LZ1DPN/Minima-2016/other-docs/Arduino-ProMini-pinout.png

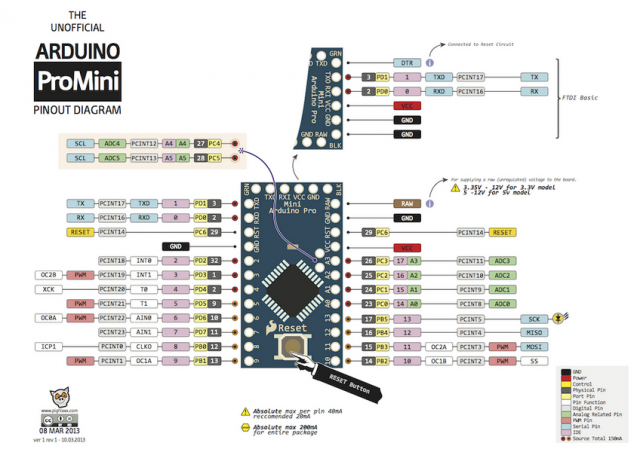
other-docs/Arduino-ProMini-pinout.png
