LZ1DPN/Minima-2016/other-docs/Version3_Schematic.jpg

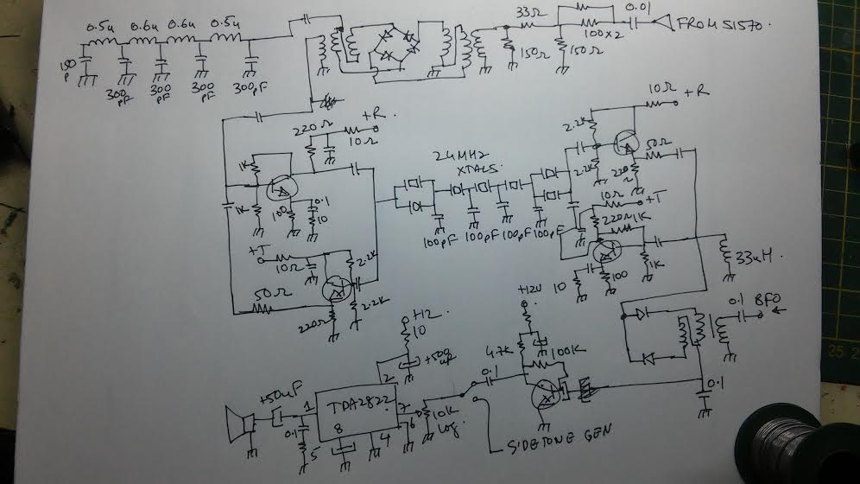
other-docs/Version3_Schematic.jpg
