LZ1DPN/Minima-2016/radiono20mhz/README.md

radiono
=======

Minima's Arduino software. Useful for controlling a homebrew Si570 based superhet transceiver/receiver.
It is primarily meant to be used with the Minima transceiver described on http://phonestack.com/farhan/minima.html

Copyright (C)2014  Ashhar Farhan

    This program is free software: you can redistribute it and/or modify
    it under the terms of the GNU General Public License as published by
    the Free Software Foundation, either version 3 of the License, or
    (at your option) any later version.

    This program is distributed in the hope that it will be useful,
    but WITHOUT ANY WARRANTY; without even the implied warranty of
    MERCHANTABILITY or FITNESS FOR A PARTICULAR PURPOSE.  See the
    GNU General Public License for more details.

    You should have received a copy of the GNU General Public License
    along with this program.  If not, see <http://www.gnu.org/licenses/>.
