LZ1DPN/Minima-2016/minima-pcb-up.jpg

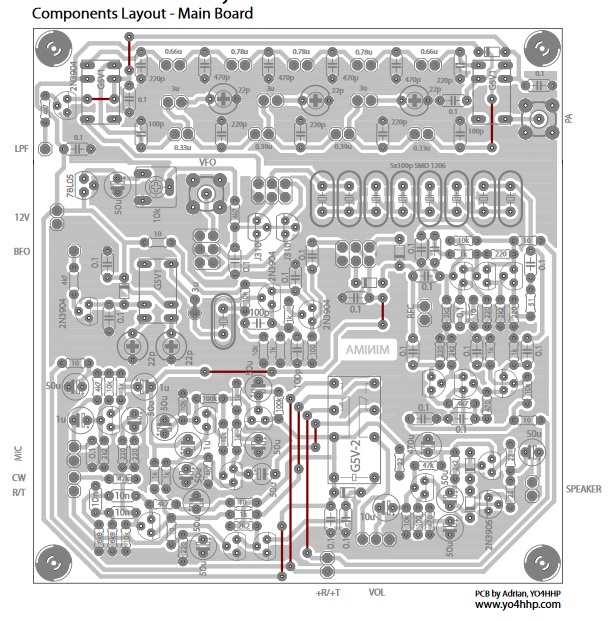
minima-pcb-up.jpg
