LZ1DPN/Minima-2016/other-docs/10W_40m_CW_Transmitter.gif

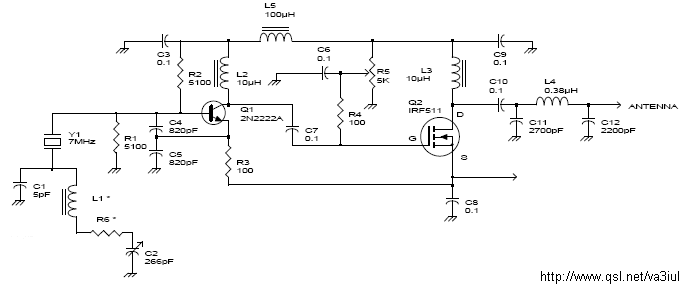
other-docs/10W_40m_CW_Transmitter.gif
