LZ1DPN/Minima-2016/other-docs/40m_12W_TX_NB6M.gif

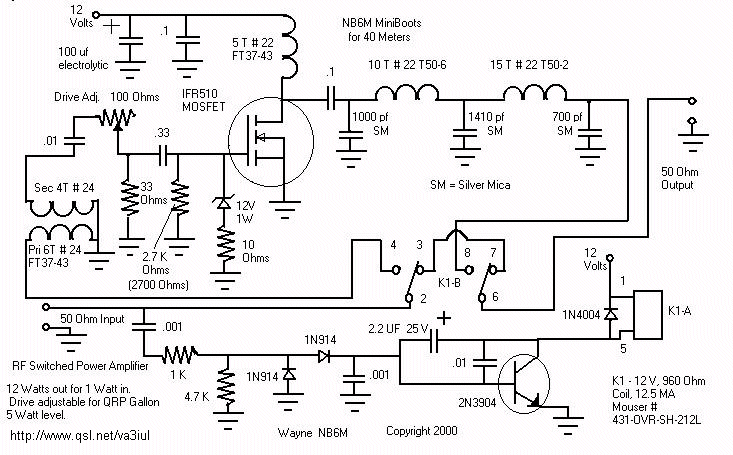
other-docs/40m_12W_TX_NB6M.gif
