LZ1DPN/Minima-2016/other-docs/1117.jpg

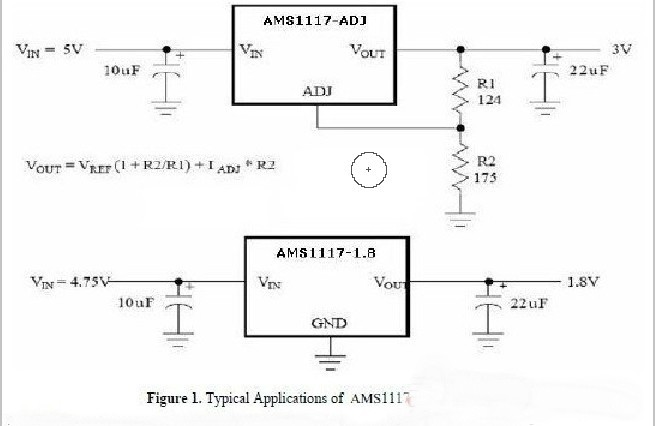
other-docs/1117.jpg
