LZ1DPN/Minima-2016/other-docs/20097132394231.gif.jpg

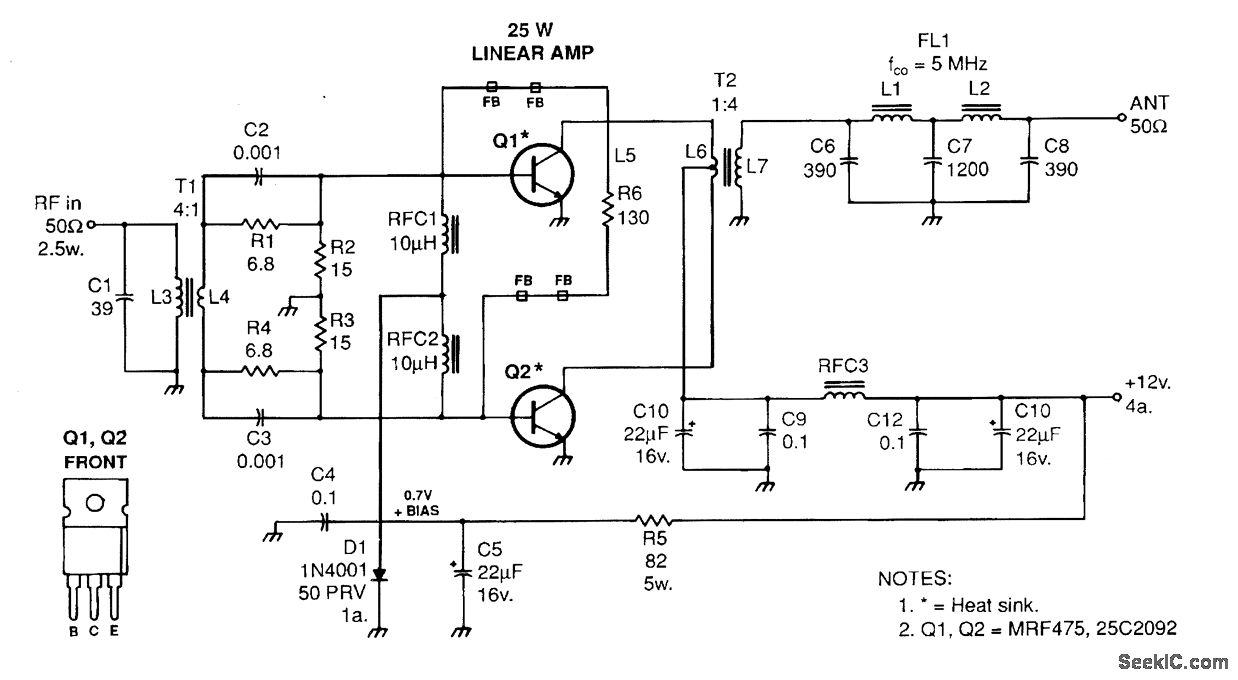
other-docs/20097132394231.gif.jpg
