LZ1DPN/Minima-2016/other-docs/arduino-pro-mini.jpg

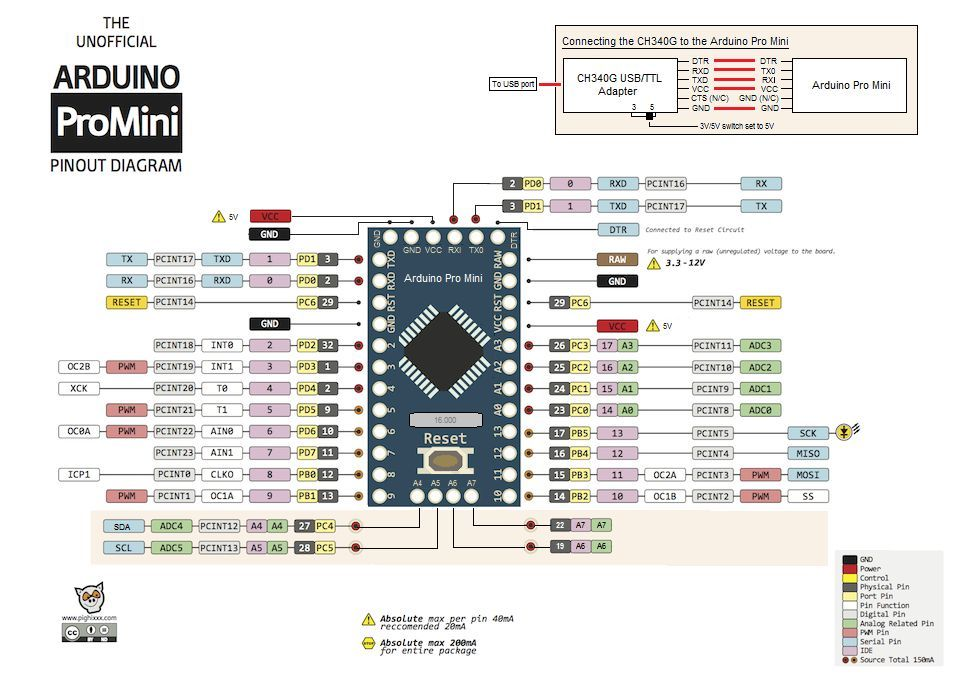
other-docs/arduino-pro-mini.jpg
