LZ1DPN/Minima-2016/other-docs/audio-af_mba810.jpg

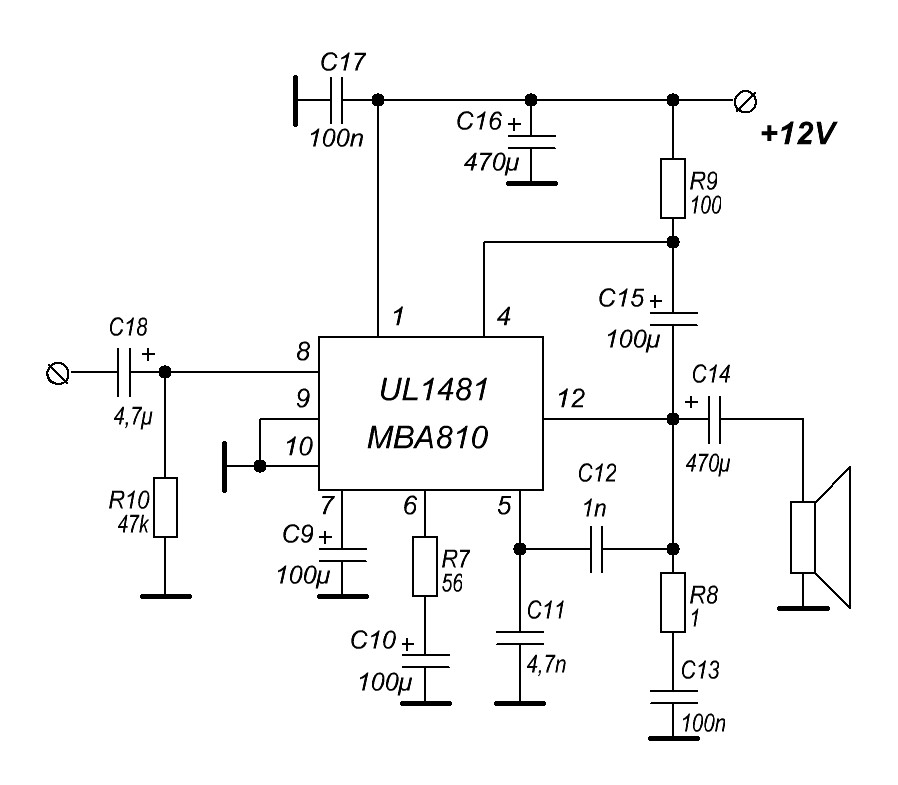
other-docs/audio-af_mba810.jpg
