LZ1DPN/Minima-2016/other-docs/audio-af_tda2003.jpg

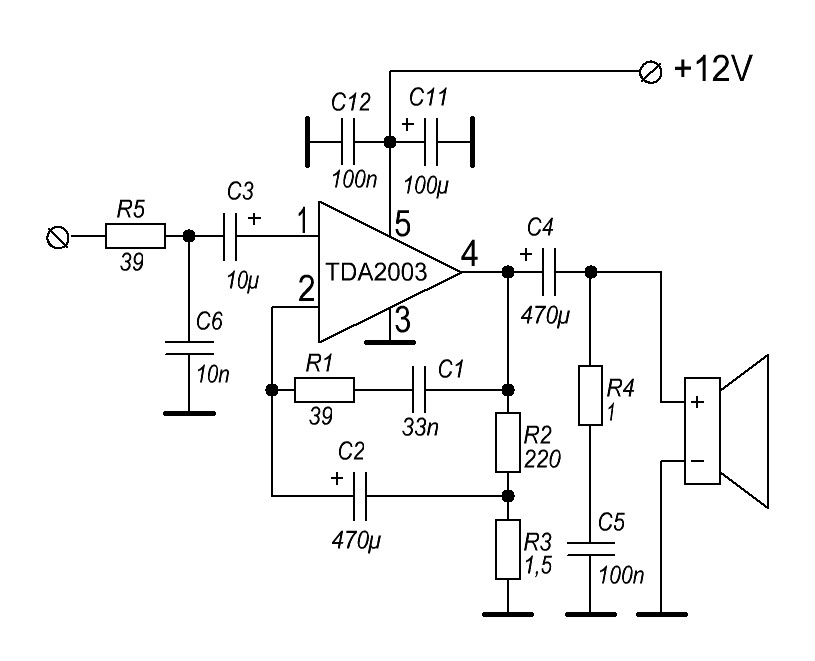
other-docs/audio-af_tda2003.jpg
