LZ1DPN/Minima-2016/other-docs/cw_gen.jpg

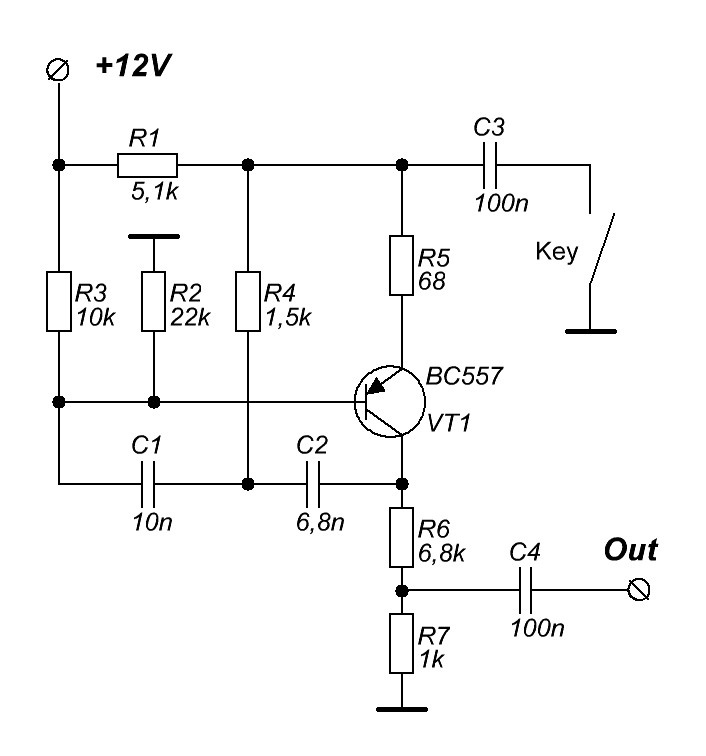
other-docs/cw_gen.jpg
