LZ1DPN/Minima-2016/other-docs/digi.jpg

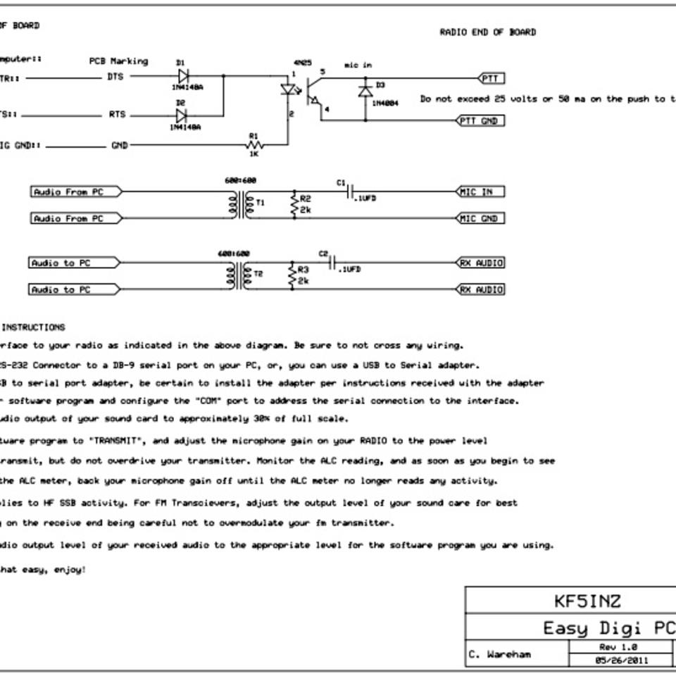
other-docs/digi.jpg
