LZ1DPN/Minima-2016/other-docs/linear_amplifier.gif

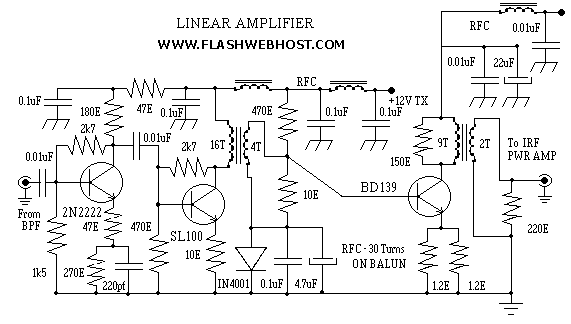
other-docs/linear_amplifier.gif
