LZ1DPN/Minima-2016/other-docs/lz1jn_swr.jpg

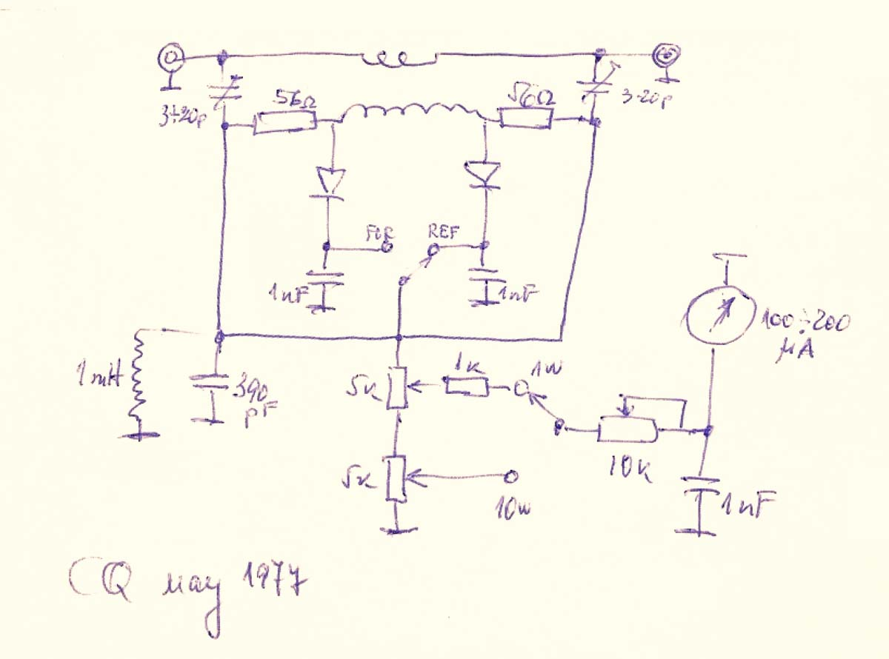
other-docs/lz1jn_swr.jpg
