LZ1DPN/Minima-2016/other-docs/Minima2.png

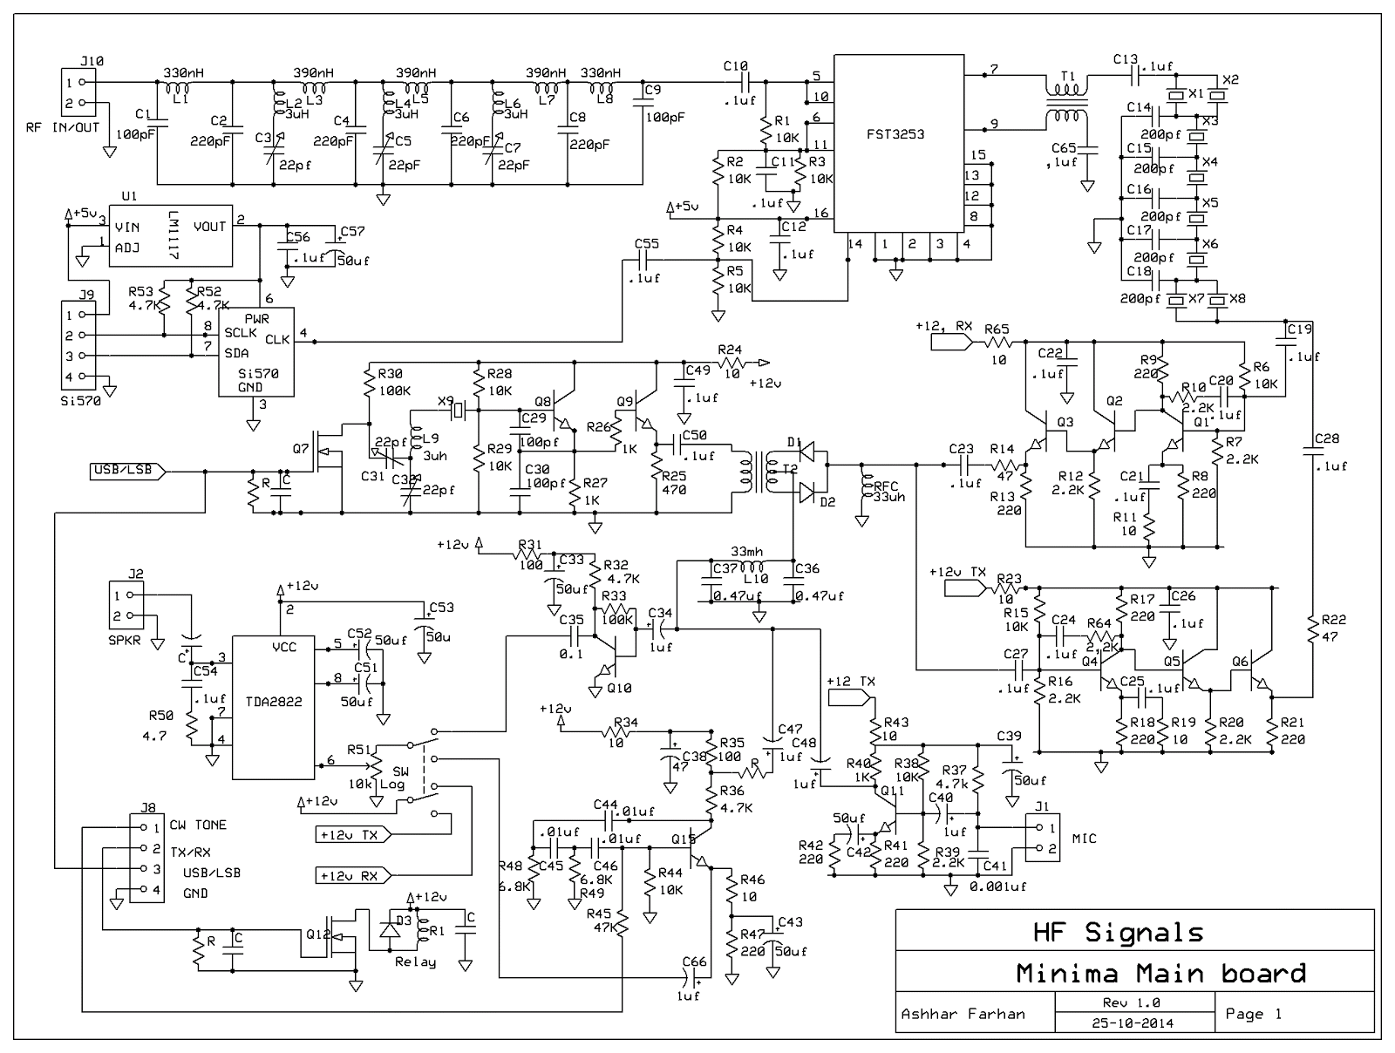
other-docs/Minima2.png
