LZ1DPN/Minima-2016/other-docs/minima-mb_layout.png

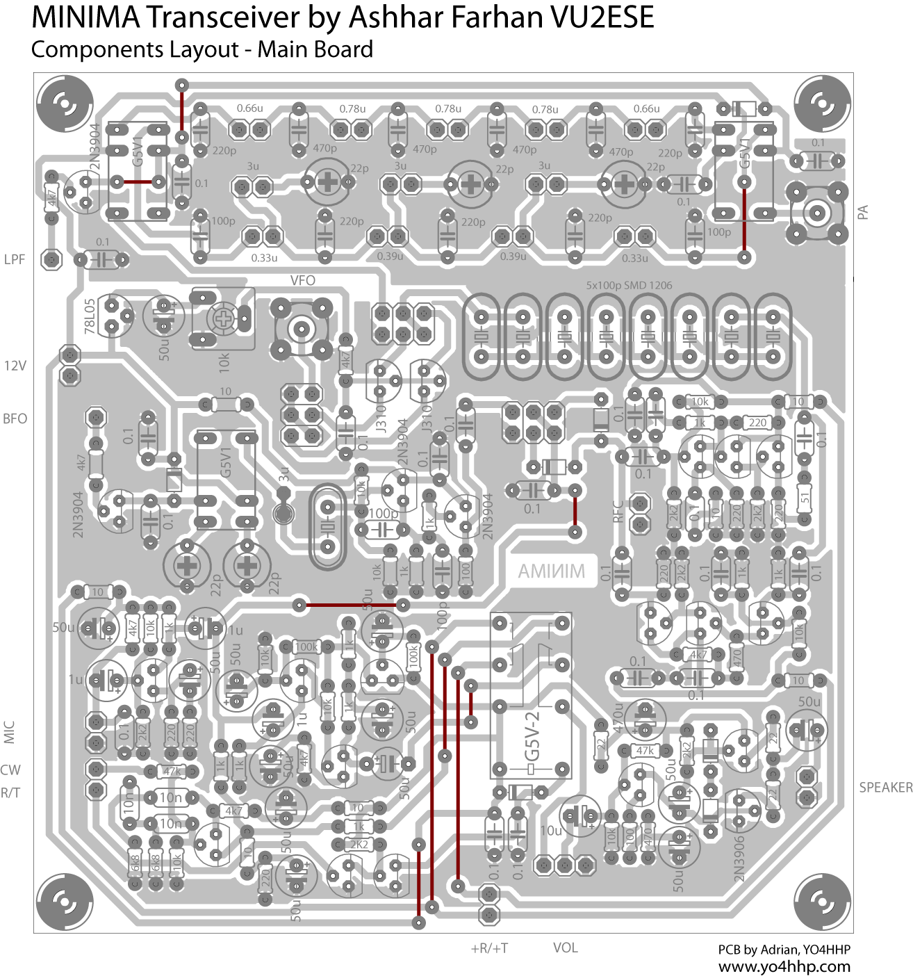
other-docs/minima-mb_layout.png
