LZ1DPN/Minima-2016/other-docs/minima-trx.jpg

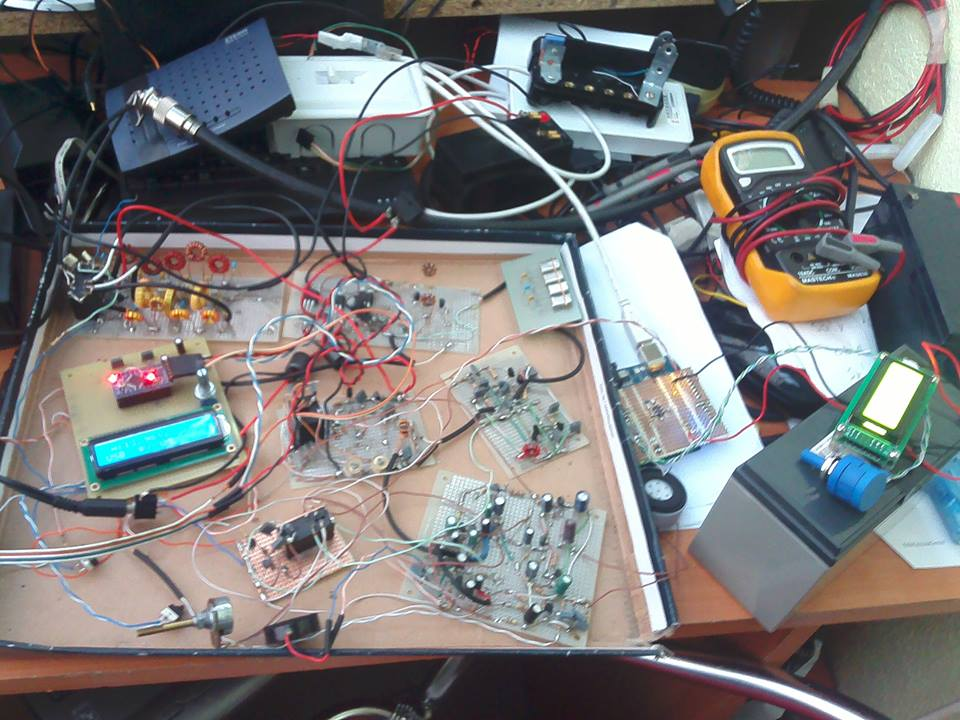
other-docs/minima-trx.jpg
