LZ1DPN/Minima-2016/other-docs/minimackt-rfamp.jpg

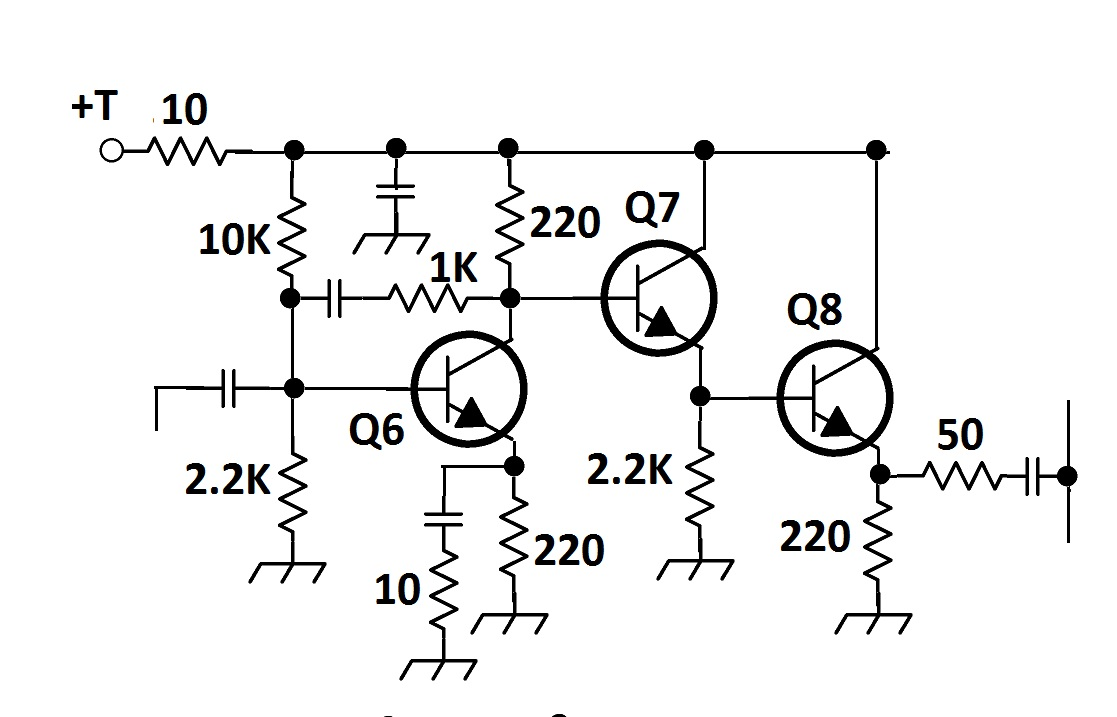
other-docs/minimackt-rfamp.jpg
