LZ1DPN/Minima-2016/other-docs/pa.jpg

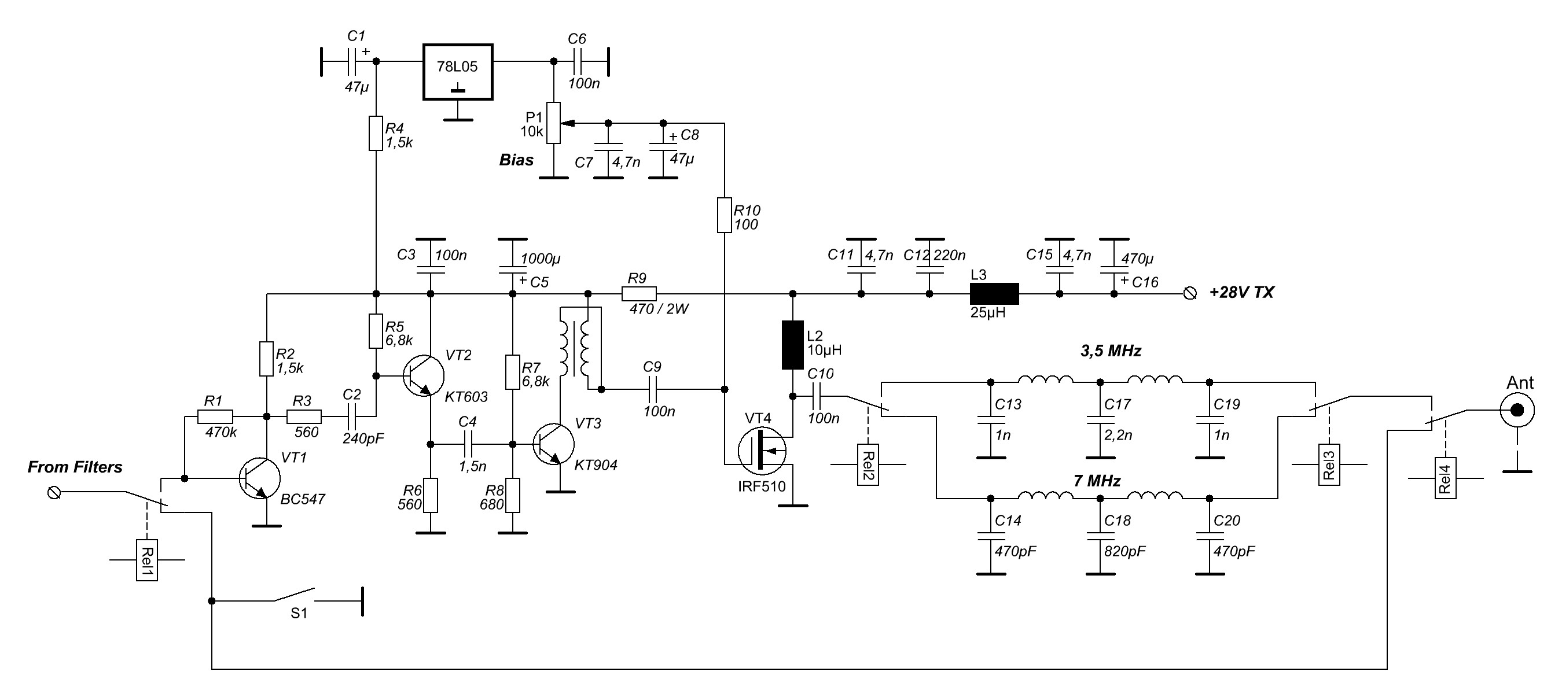
other-docs/pa.jpg
