LZ1DPN/Minima-2016/other-docs/rst_qrp_tx_boia_fria.gif

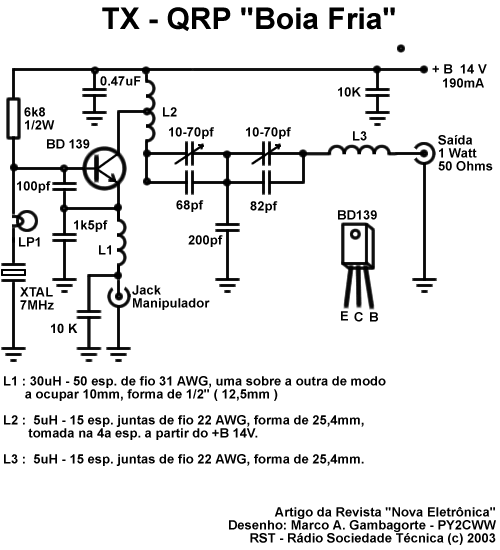
other-docs/rst_qrp_tx_boia_fria.gif
