LZ1DPN/Minima-2016/other-docs/Single-Transistor-Amplifier.gif

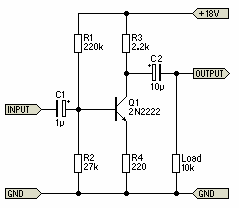
other-docs/Single-Transistor-Amplifier.gif
