LZ1DPN/Minima-2016/other-docs/sketch.jpg

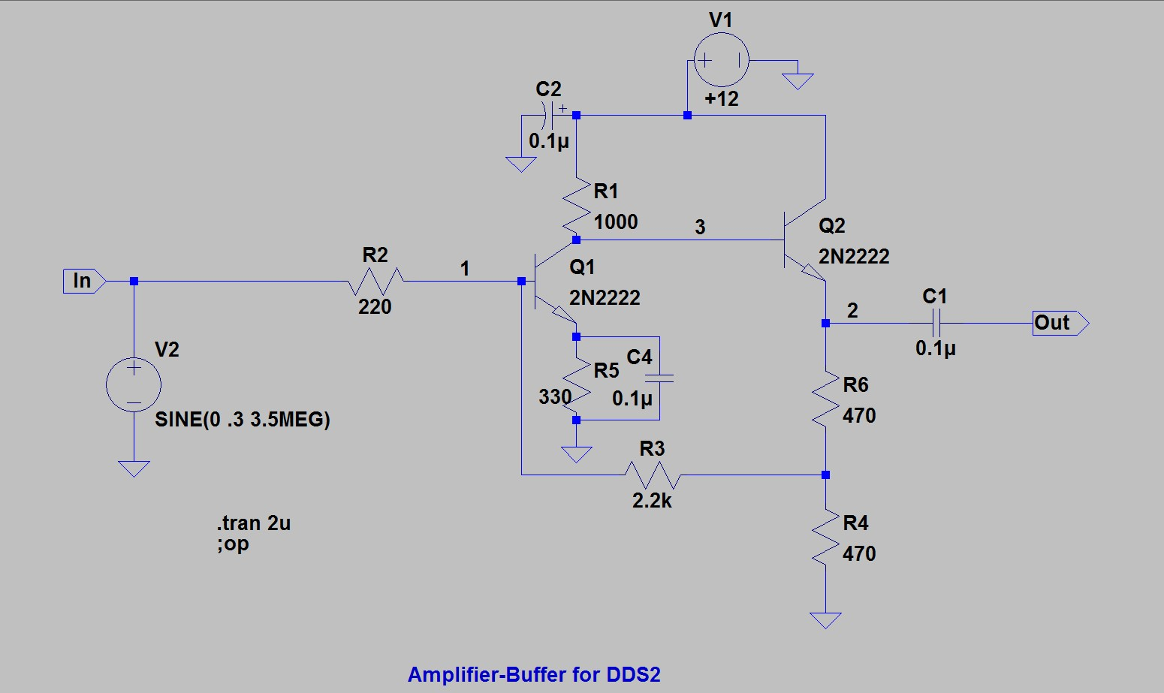
other-docs/sketch.jpg
