LZ1DPN/Minima-2016/other-docs/transistor-J310.jpg

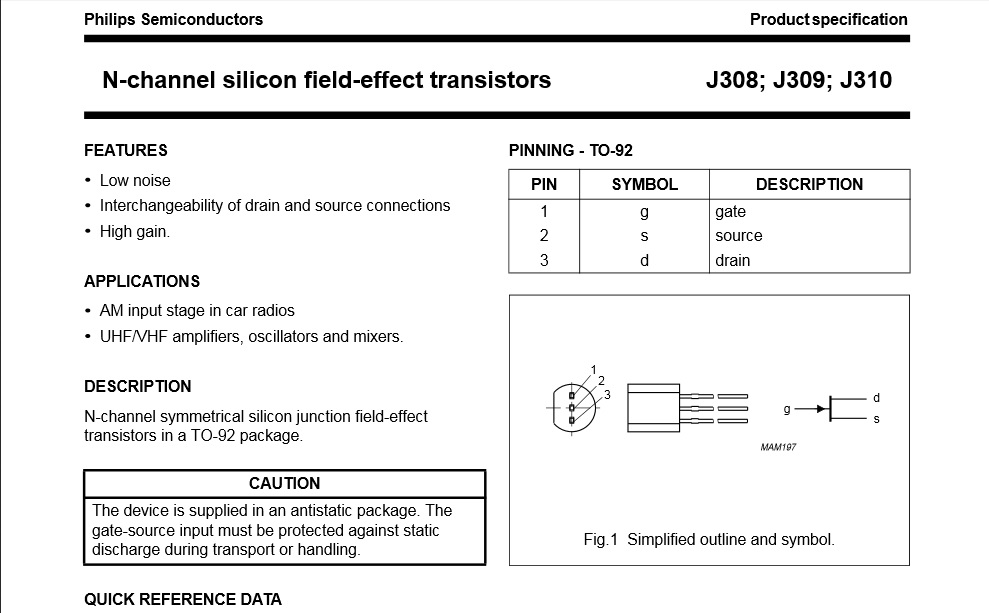
other-docs/transistor-J310.jpg
