LZ1DPN/Minima-2016/minima-mb_layout.pdf

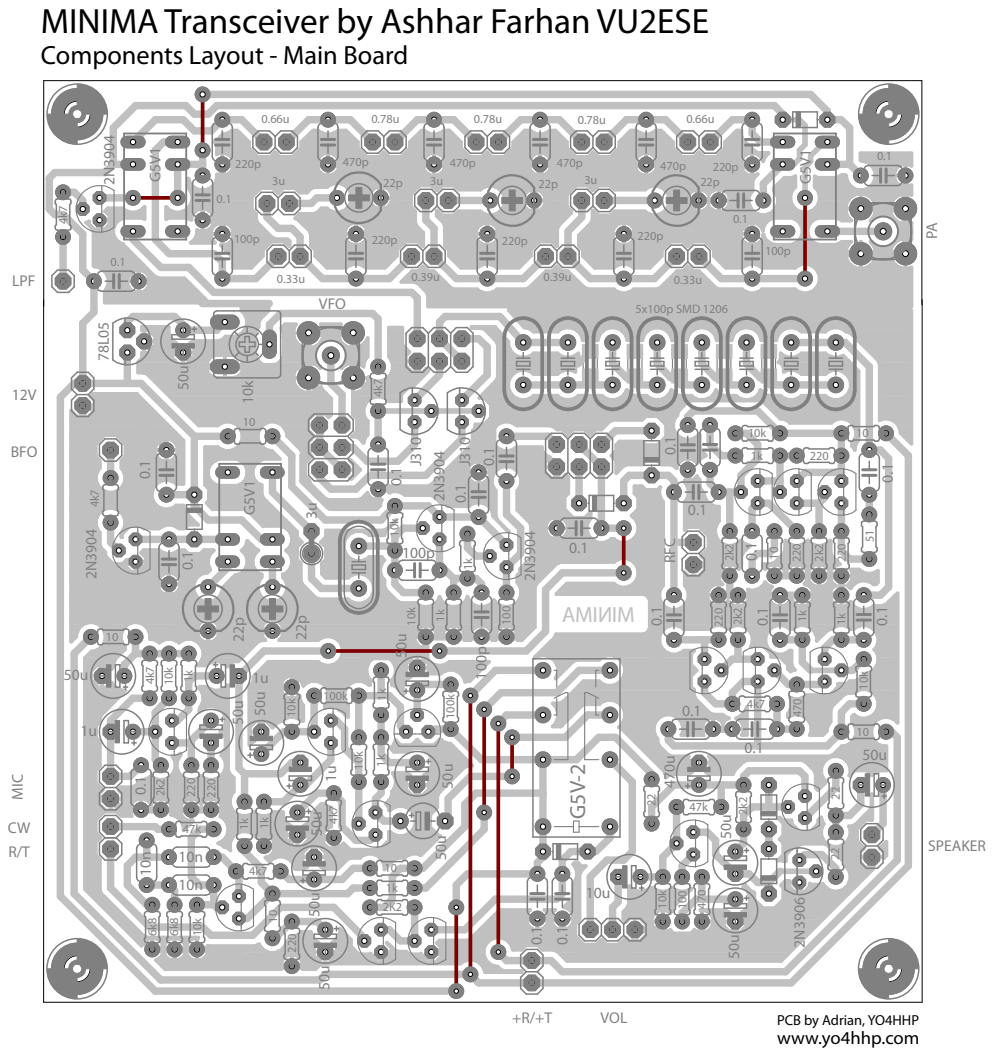
[picture p79: page 1]
RFC; MIC; 1u ²N³⁹⁰⁴; BFO; VFO; G5V-2 VOL; 10 ⁵⁰u; LPF; SPEAKER; 5x100p SMD 1206

MINIMA Transceiver by Ashhar Farhan VU2ESE
Components Layout - Main Board

PCB by Adrian, YO4HHP
www.yo4hhp.com
