LZ1DPN/Minima-2016/other-docs/HF1-1.pdf

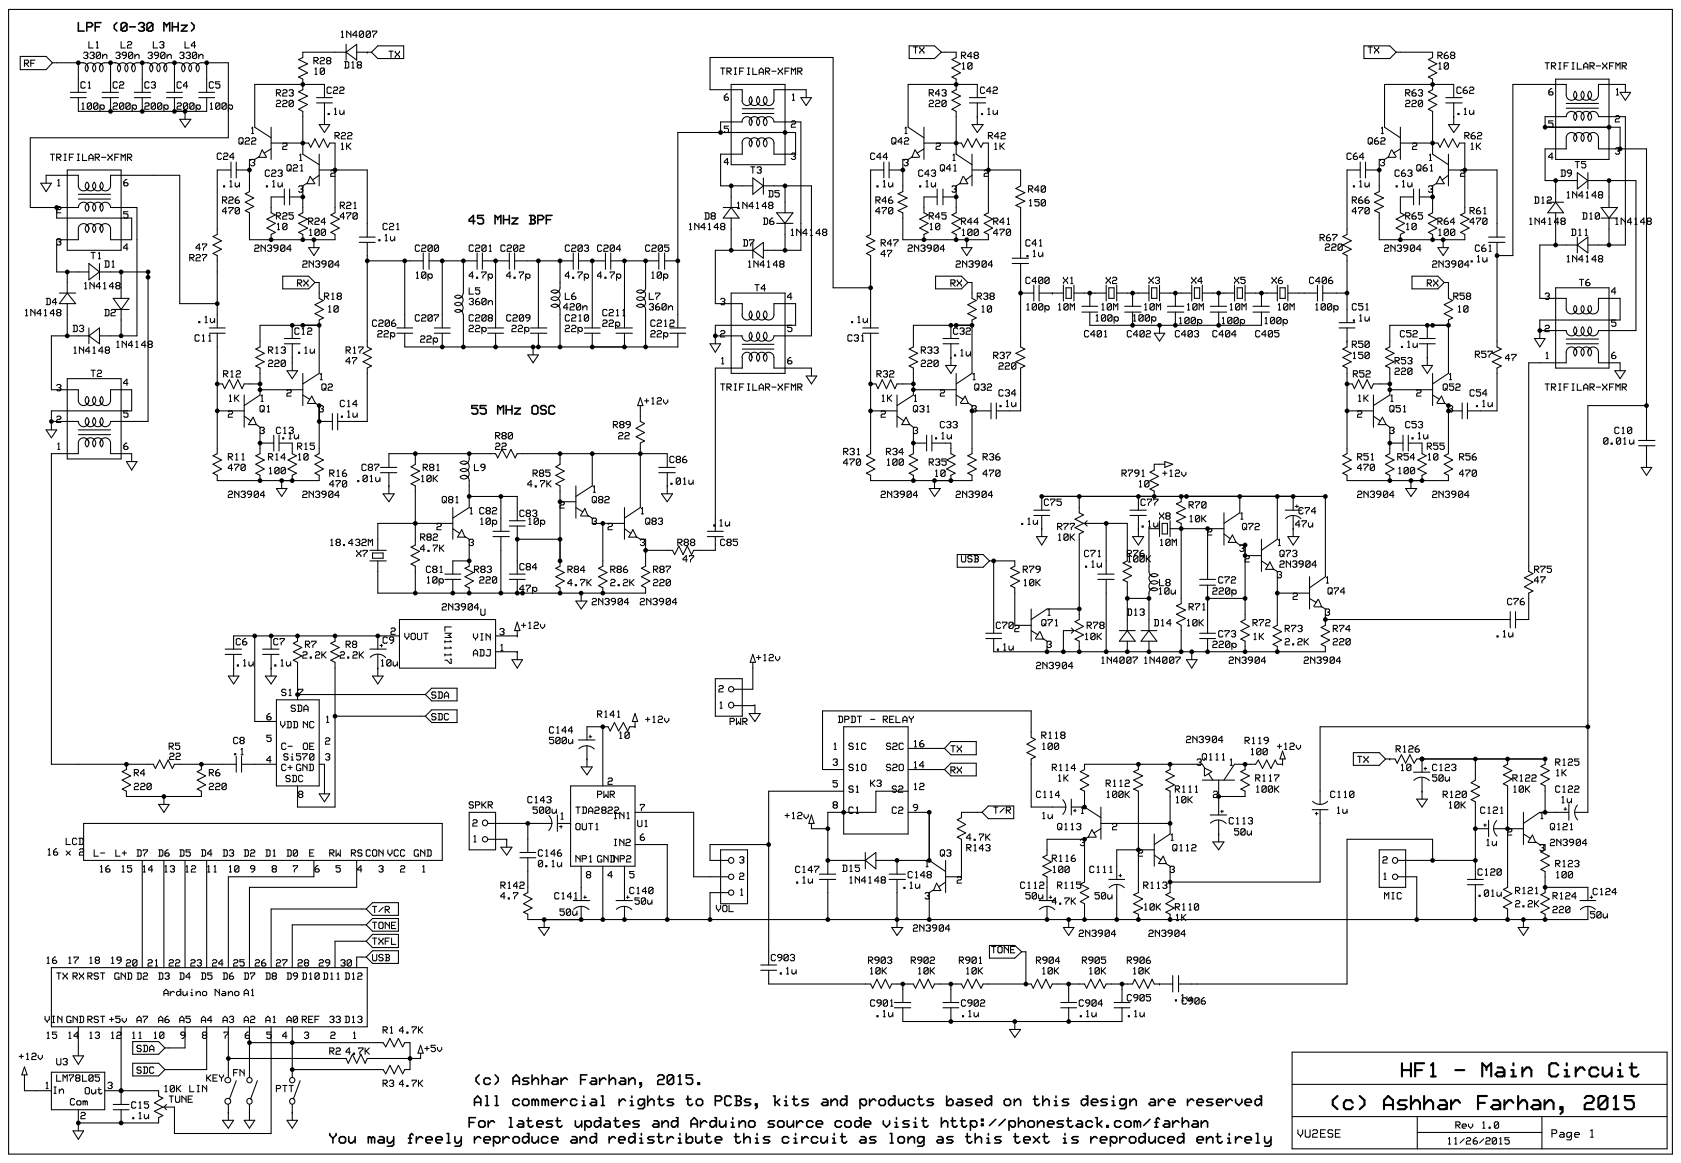
[picture p80: page 1]
