LZ1DPN/Minima-2016/other-docs/HF1-2.pdf

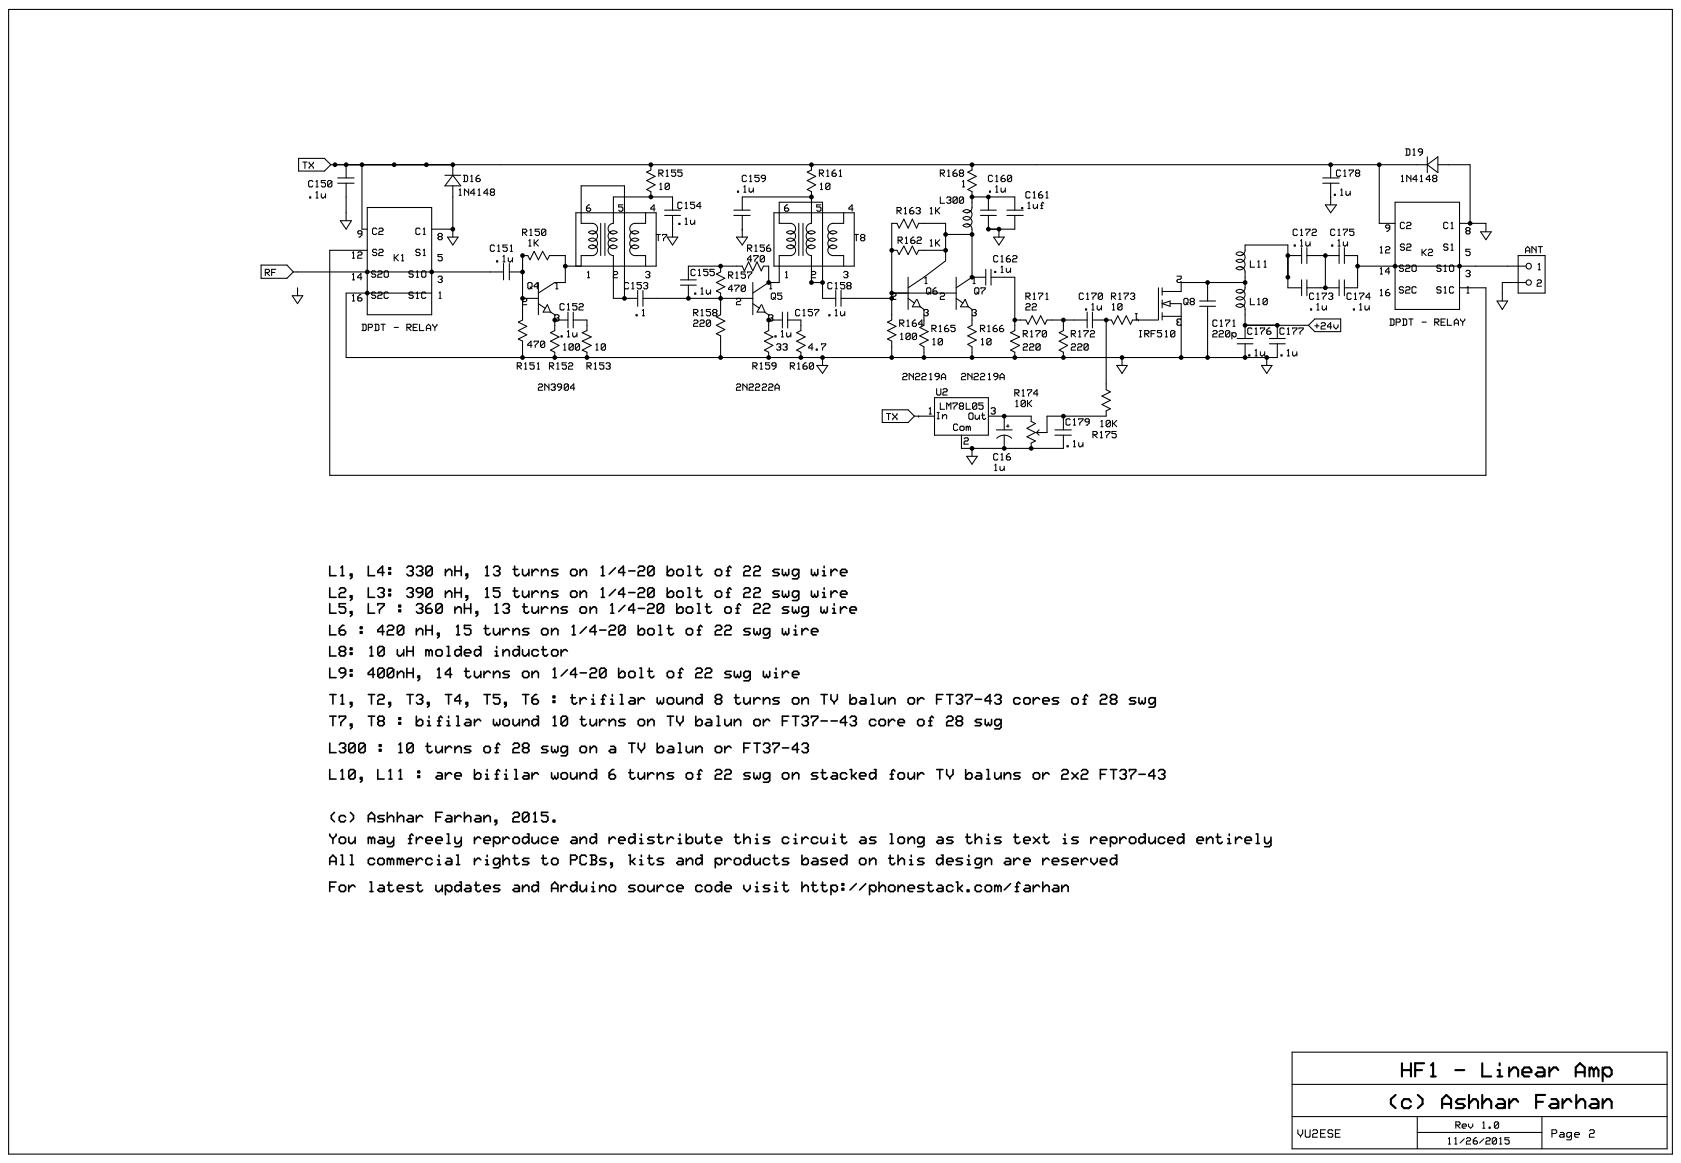
[picture p81: page 1]
