LZ1DPN/Minima-2016/other-docs/HF1.pdf

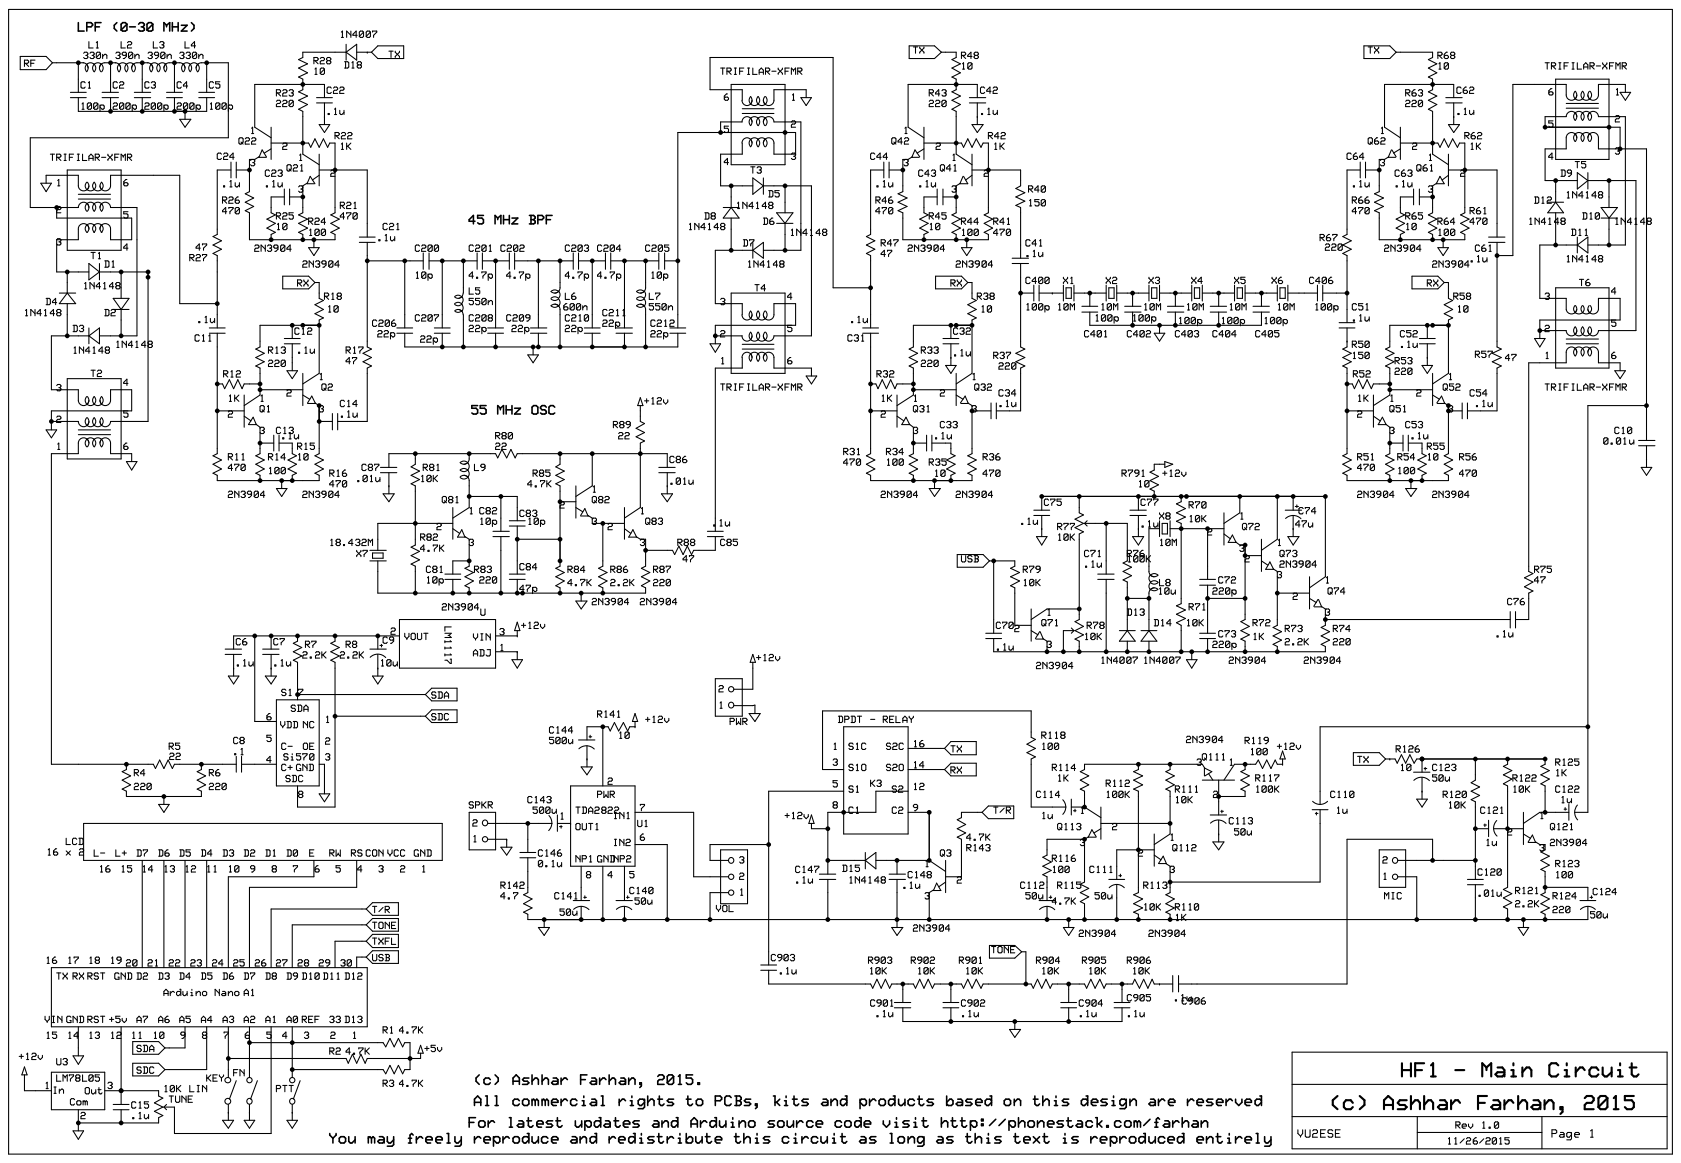
[picture p82: page 1]
