LZ1DPN/Minima-2016/mainboard/Main Board/untitled.brd

## EAGLE design mainboard/Main Board/untitled.brd (2016-10-19)

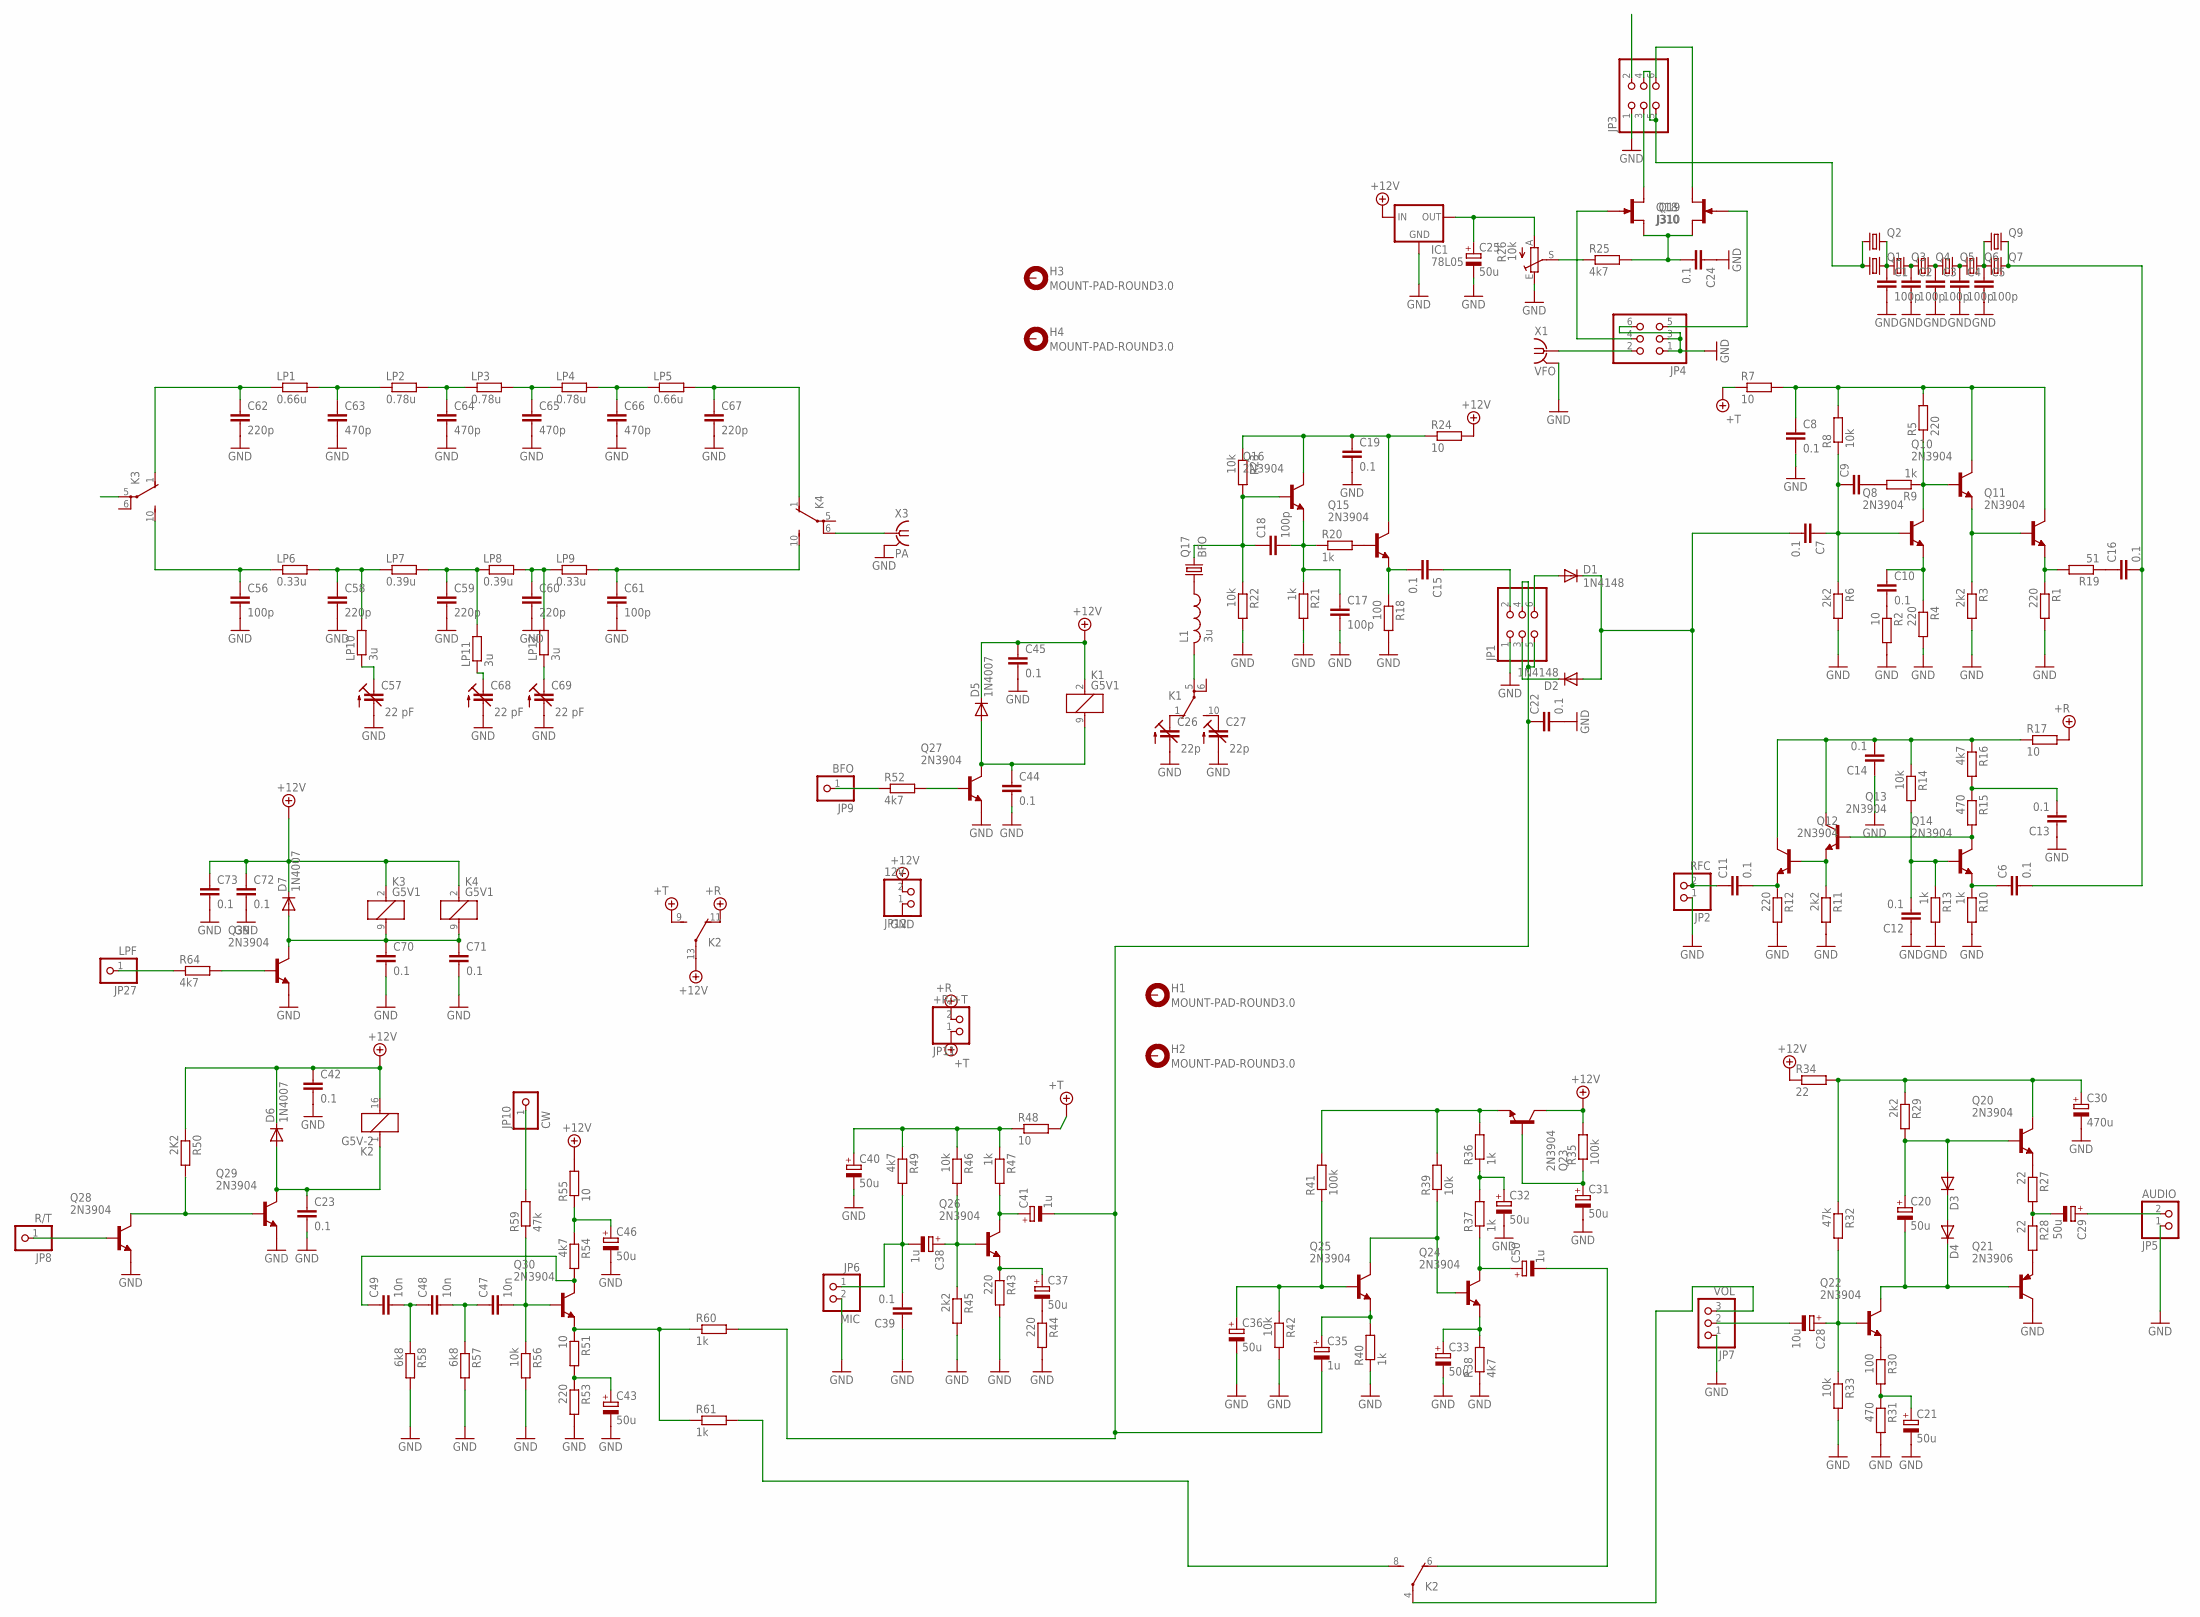
[picture p83: schematic untitled.sch]

Parts:
C1, C2, C3, C4, C5: 100p; C1206
C6, C7, C8, C10, C11, C12, C13, C14, C15, C16, C19, C22, C23, C24, C39, C42, C44, C45, C70, C71, C72, C73: 0.1; C050-024X044
C9: C-EU050-024X044; C050-024X044
C17, C18, C56, C61: 100p; C050-024X044
C20, C21, C25, C29, C31, C32, C33, C36, C37, C40, C43, C46: 50u; E2,5-5
C26, C27: 22p; CTRIMTZ03
C28: 10u; E2,5-5
C30: 470u; E2,5-5
C35, C38, C41: 1u; E2,5-5
C47, C48, C49: 10n; C050-024X044
C50: 1u; E5-4
C57, C68, C69: 22 pF; CTRIMTZ03
C58, C59, C60, C62, C67: 220p; C050-024X044
C63, C64, C65, C66: 470p; C050-024X044
D1, D2: 1N4148; D-5
D3, D4: DIODE-D-5; D-5
D5, D6, D7: 1N4007; D-5
H1, H2, H3, H4: MOUNT-PAD-ROUND3.0; 3,0-PAD
IC1: 78L05; 78LXX
JP1, JP3, JP4: PINHD-2X3; 2X03
JP2: RFC; 1X02
JP5: AUDIO; 1X02
JP6: MIC; 1X02
JP7: VOL; 1X03
JP8: R/T; 1X01
JP9: BFO; 1X01
JP10: CW; 1X01
JP11: +R/+T; 1X02
JP12: 12V; 1X02
JP27: LPF; 1X01
K1, K3, K4: G5V1
K2: G5V-2
L1: 3u; 0207/2V
LP1, LP5: 0.66u; 0204/5
LP2, LP3, LP4: 0.78u; 0204/5
LP6, LP9: 0.33u; 0204/5
LP7, LP8: 0.39u; 0204/5
LP10, LP11, LP12: 3u; 0204/5
Q1, Q2, Q3, Q4, Q5, Q6, Q7, Q9: CRYSTALHC49S; HC49/S
Q8, Q10, Q11, Q12, Q13, Q14, Q15, Q16, Q20, Q22, Q23, Q24, Q25, Q26, Q27, Q28, Q29, Q30, Q39: 2N3904; TO92
Q17: BFO; HC49/S
Q18, Q19: J310; TO92R
Q21: 2N3906; TO92
R1, R4, R5, R12, R43, R44, R53: 220; 0204/5
R2, R7, R17, R24, R48, R51, R55: 10; 0204/5
R3, R6, R11, R29, R45: 2k2; 0204/5
R8, R14, R22, R23, R33, R39, R42, R46, R56: 10k; 0204/5
R9, R10, R13, R20, R21, R36, R37, R40, R47, R60, R61: 1k; 0204/5
R15, R31: 470; 0204/5
R16, R25, R38, R49, R52, R54, R64: 4k7; 0204/5
R18, R30: 100; 0204/5
R19: 51; 0204/5
R26: 10k; CA6V
R27, R28, R34: 22; 0204/5
R32, R59: 47k; 0204/5
R35, R41: 100k; 0204/5
R50: 2K2; 0204/5
R57, R58: 6k8; 0204/5
X1: VFO; BU-SMA-V
X3: PA; BU-SMA-V

Connections:
+5V/1: JP11.2, K2.11 (O), R17.2
+5V/2: JP11.1, K2.9 (S), R7.1, R48.2
+12V: C42.1, C45.1, C72.1, C73.1, D5.C, D6.C, D7.C, IC1.IN, JP12.2, K1.2 (1), K2.13, K2.16 (2), K3.2 (1), K4.2 (1), Q23.1 (C), R24.2, R34.1, R35.2, R50.1, R55.2
GND: C1.2, C2.2, C3.2, C4.2, C5.2, C8.2, C12.1, C13.1, C14.1, C17.2, C19.2, C21.-, C22.2, C23.2, C24.1, C25.-, C26.2 (A), C27.2 (A), C30.-, C31.-, C32.-, C33.-, C36.-, C39.1, C40.-, C42.2, C43.-, C44.2, C45.2, C46.-, C56.2, C57.2 (A), C58.2, C59.2, C60.2, C61.2, C62.2, C63.2, C64.2, C65.2, C66.2, C67.2, C68.2 (A), C69.2 (A), C70.2, C71.2, C72.2, C73.2, IC1.GND, JP1.1, JP2.1, JP3.1, JP4.1, JP4.3, JP4.6, JP5.1, JP6.2, JP7.1, JP12.1, Q21.1 (C), Q27.3 (E), Q28.3 (E), Q29.3 (E), Q39.3 (E), R1.2, R2.2, R3.2, R4.2, R6.2, R10.2, R11.2, R12.2, R13.2, R18.2, R21.2, R22.2, R26.E, R31.2, R33.2, R38.1, R40.1, R42.2, R43.2, R44.2, R45.2, R53.2, R56.2, R57.2, R58.2, X1.2 (GND), X1.3 (GND), X1.4 (GND), X1.5 (GND), X3.2 (GND), X3.3 (GND), X3.4 (GND), X3.5 (GND)
unnamed: C1.1, Q1.2, Q2.2, Q3.1
unnamed: C2.1, Q3.2, Q4.1
unnamed: C3.1, Q4.2, Q5.1
unnamed: C4.1, Q5.2, Q6.1
unnamed: C5.1, Q6.2, Q7.1, Q9.1
unnamed: C6.2, C16.2, Q7.2, Q9.2
unnamed: C26.1 (E), K1.1 (O)
unnamed: C10.1, Q8.3 (E), R4.1
unnamed: C10.2, R2.1
unnamed: C7.1, C9.1, Q8.2 (B), R6.1, R8.1
unnamed: Q8.1 (C), Q10.2 (B), R5.1, R9.1
unnamed: Q10.3 (E), Q11.2 (B), R3.1
unnamed: Q11.3 (E), R1.1, R19.2
unnamed: C8.1, Q10.1 (C), Q11.1 (C), R5.2, R7.2, R8.2
unnamed: C16.1, R19.1
unnamed: C9.2, R9.2
unnamed: Q12.2 (B), Q13.3 (E), R11.1
unnamed: C11.2, Q12.3 (E), R12.1
unnamed: C14.2, Q12.1 (C), Q13.1 (C), R14.1, R16.1, R17.1
unnamed: C27.1 (E), K1.10 (S)
unnamed: C12.2, Q14.2 (B), R13.1, R14.2
unnamed: C6.1, Q14.3 (E), R10.1
unnamed: Q13.2 (B), Q14.1 (C), R15.2
unnamed: C13.2, R15.1, R16.2
unnamed: C15.2, Q15.3 (E), R18.1
unnamed: Q15.2 (B), R20.2
unnamed: C17.1, C18.2, Q16.3 (E), R20.1, R21.1
unnamed: C19.1, Q15.1 (C), Q16.1 (C), R23.1, R24.1
unnamed: C15.1, JP1.2
unnamed: C18.1, Q16.2 (B), Q17.2, R22.1, R23.2
unnamed: L1.1, Q17.1
unnamed: K1.5, L1.2
unnamed: R25.1, R26.S
unnamed: Q20.3 (E), R27.1
unnamed: Q27.2 (B), R52.2
unnamed: D1.A, JP1.6
unnamed: D2.C, JP1.3
unnamed: C7.2, C11.1, D1.C, D2.A, JP2.2
unnamed: JP3.4, JP3.5, Q1.1, Q2.1
unnamed: JP3.3, Q18.D
unnamed: JP3.6, Q19.D
unnamed: C24.2, Q18.S, Q19.S, R25.2
unnamed: JP4.5, Q19.G
unnamed: JP4.4, Q18.G
unnamed: C29.-, R27.2, R28.1
unnamed: JP4.2, X1.1
unnamed: Q21.3 (E), R28.2
unnamed: C25.+, IC1.OUT, R26.A
unnamed: D3.C, D4.A
unnamed: C20.-, D4.C, Q21.2 (B), Q22.1 (C)
unnamed: C20.+, D3.A, Q20.2 (B), R29.2
unnamed: C30.+, Q20.1 (C), R29.1, R32.1, R34.2
unnamed: Q22.3 (E), R30.1
unnamed: C21.+, R30.2, R31.1
unnamed: C28.+, Q22.2 (B), R32.2, R33.1
unnamed: C29.+, JP5.2
unnamed: C28.-, JP7.2
unnamed: C31.+, Q23.2 (B), R35.1
unnamed: Q23.3 (E), R36.2, R39.2, R41.2
unnamed: C32.+, R36.1, R37.2
unnamed: C50.+, Q24.1 (C), R37.1
unnamed: C33.+, Q24.3 (E), R38.2
unnamed: Q24.2 (B), Q25.1 (C), R39.1
unnamed: JP9.1, R52.1
unnamed: C35.+, Q25.3 (E), R40.2
unnamed: C36.+, Q25.2 (B), R41.1, R42.1
unnamed: C37.+, Q26.3 (E), R43.1
unnamed: C37.-, R44.1
unnamed: C38.+, Q26.2 (B), R45.1, R46.2
unnamed: C41.+, Q26.1 (C), R47.2
unnamed: C40.+, R46.1, R47.1, R48.1, R49.1
unnamed: C38.-, C39.2, JP6.1, R49.2
unnamed: JP7.3, K2.4
unnamed: C22.1, C35.-, C41.-, JP1.4, JP1.5, R60.2
unnamed: C50.-, K2.6 (O)
unnamed: JP8.1, Q28.2 (B)
unnamed: C23.1, D6.A, K2.1, Q29.1 (C)
unnamed: Q28.1 (C), Q29.2 (B), R50.2
unnamed: C44.1, D5.A, K1.9 (2), Q27.1 (C)
unnamed: C57.1 (E), LP10.1
unnamed: Q30.3 (E), R51.1, R60.1, R61.1
unnamed: C43.+, R51.2, R53.1
unnamed: C49.1, Q30.1 (C), R54.2
unnamed: C46.+, R54.1, R55.1
unnamed: C47.2, Q30.2 (B), R56.1, R59.1
unnamed: C47.1, C48.2, R57.1
unnamed: C48.1, C49.2, R58.1
unnamed: C68.1 (E), LP11.1
unnamed: JP10.1, R59.2
unnamed: K2.8 (S), R61.2
unnamed: C56.1, K3.10 (S), LP6.1
unnamed: C58.1, LP6.2, LP7.1, LP10.2
unnamed: C59.1, LP7.2, LP8.1, LP11.2
unnamed: C60.1, LP8.2, LP9.1, LP12.2
unnamed: C61.1, K4.10 (S), LP9.2
unnamed: C62.1, K3.1 (O), LP1.1
unnamed: C63.1, LP1.2, LP2.1
unnamed: C64.1, LP2.2, LP3.1
unnamed: C65.1, LP3.2, LP4.1
unnamed: C66.1, LP4.2, LP5.1
unnamed: C67.1, K4.1 (O), LP5.2
unnamed: K4.6, X3.1
unnamed: JP3.2, K3.5
unnamed: C69.1 (E), LP12.1
unnamed: Q39.2 (B), R64.2
unnamed: JP27.1, R64.1
unnamed: C70.1, C71.1, D7.A, K3.9 (2), K4.9 (2), Q39.1 (C)

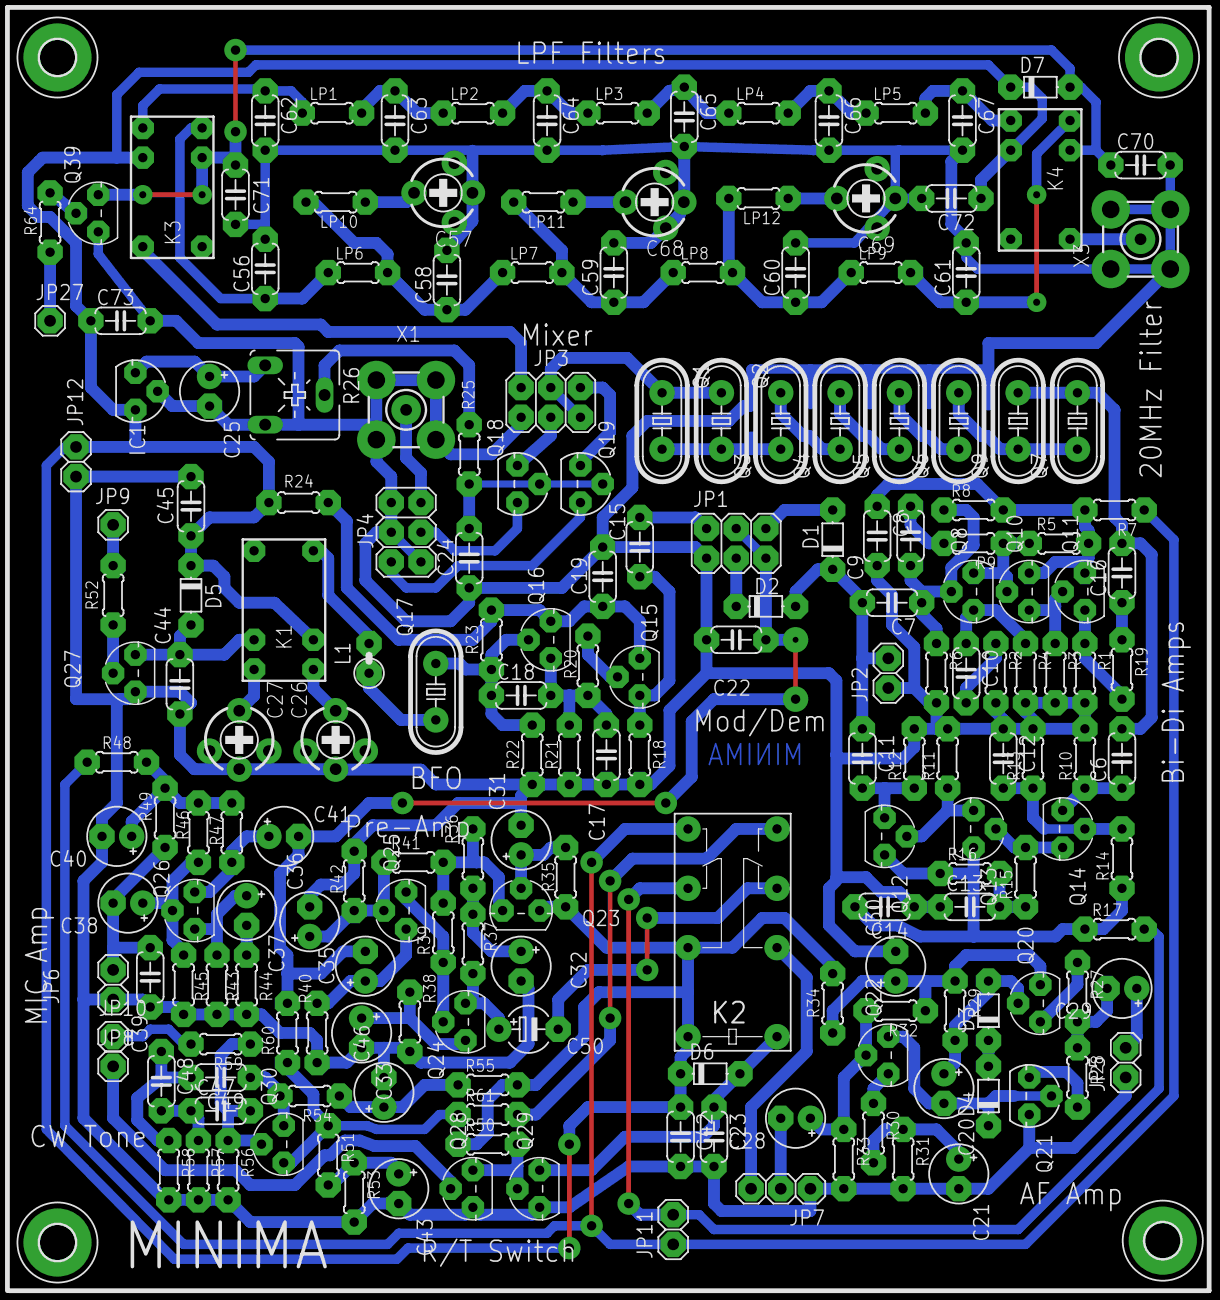
[picture p84: board untitled.brd from above]

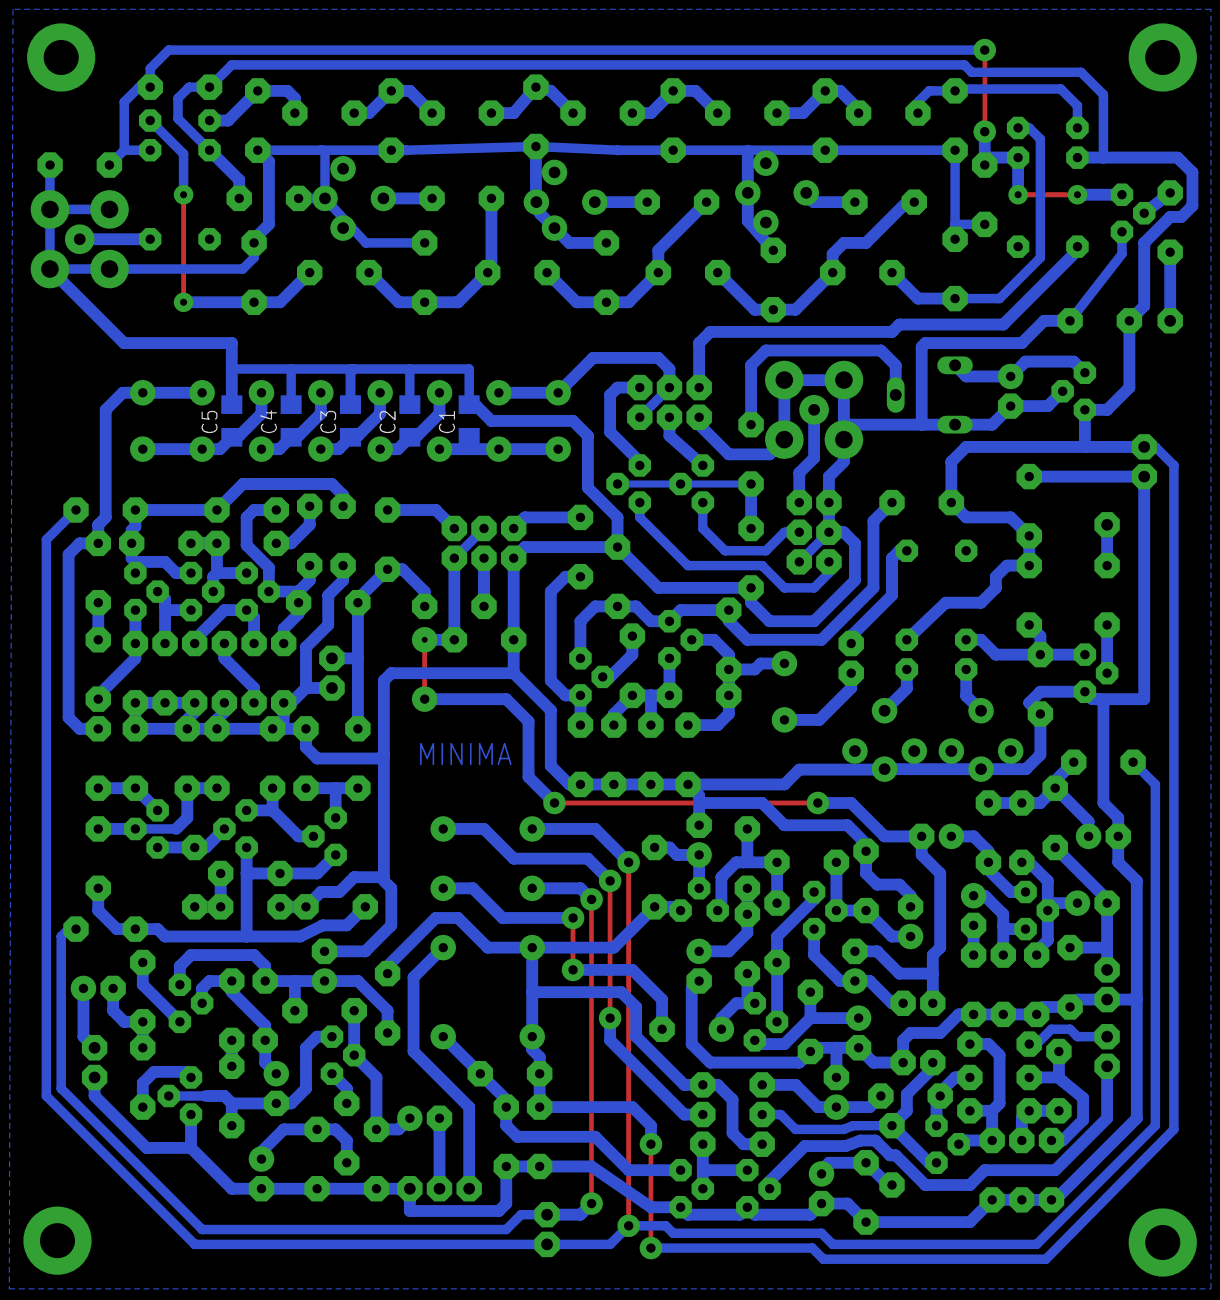
[picture p85: board untitled.brd from below]

Board: 2 copper layers, 204 parts (5 on the bottom side), 111 nets.
